kumekay/aronia/case/3mf/Aronia Case v35_Aronia Case v35_FFC Connector_1_FFC Connector.3mf

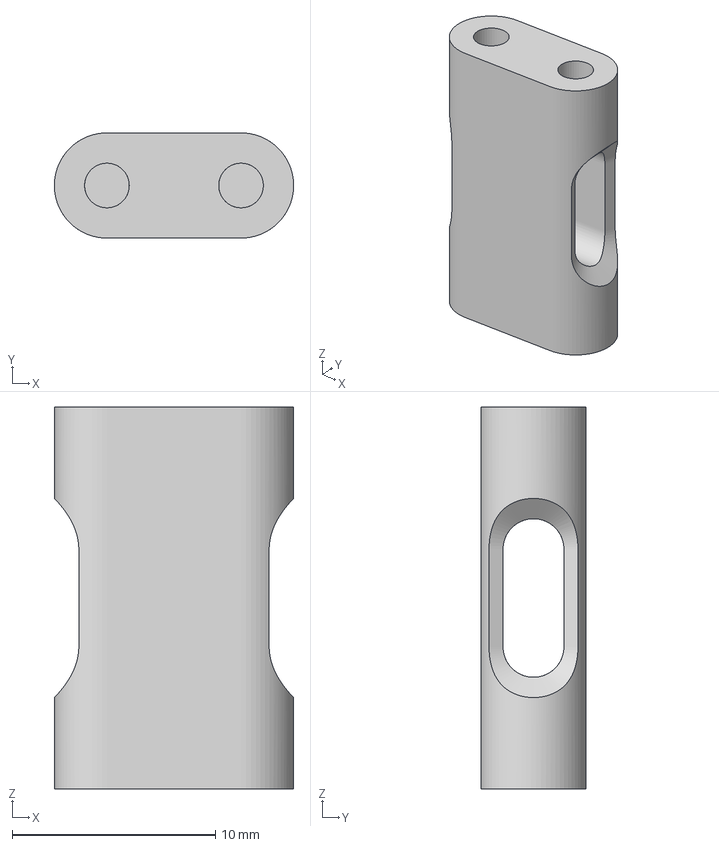
[picture p4: CAD file, 2025-06-29]
case/3mf/Aronia Case v35_Aronia Case v35_FFC Connector_1_FFC Connector.3mf
11.8 x 5.18 x 18.8 mm
