kumekay/aronia/flashing_helper/3mf/Pogo Flash v4_Pogo Flash v4_PCB Aligner.3mf

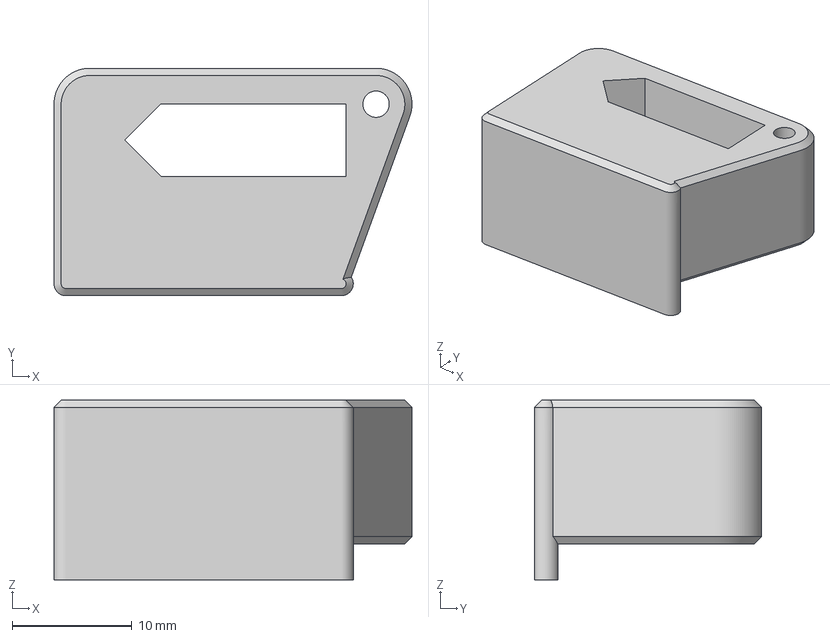
[picture p5: CAD file, 2025-06-29]
flashing_helper/3mf/Pogo Flash v4_Pogo Flash v4_PCB Aligner.3mf
29.9 x 19.0 x 15.0 mm
