kumekay/aronia/case/3mf/Aronia Case v35_Aronia Case v35_Spur Gear A_1_Gear A.3mf

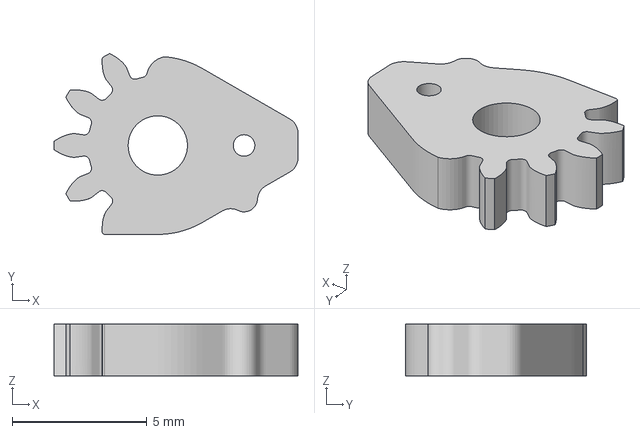
[picture p6: CAD file, 2025-06-29]
case/3mf/Aronia Case v35_Aronia Case v35_Spur Gear A_1_Gear A.3mf
9.05 x 6.71 x 1.92 mm
