kumekay/aronia/flashing_helper/3mf/Pogo Flash v4_Pogo Flash v4_Top cover_1_Cover.3mf

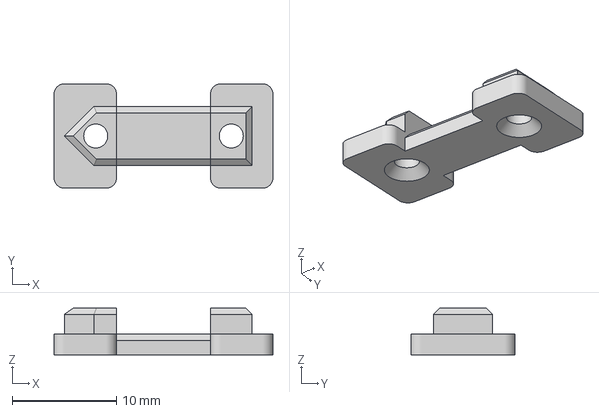
[picture p7: CAD file, 2025-06-29]
flashing_helper/3mf/Pogo Flash v4_Pogo Flash v4_Top cover_1_Cover.3mf
21.0 x 10.0 x 4.50 mm
