kumekay/aronia/case/3mf/Aronia Case v35_Aronia Case v35_Left Half_1_Left Half.3mf

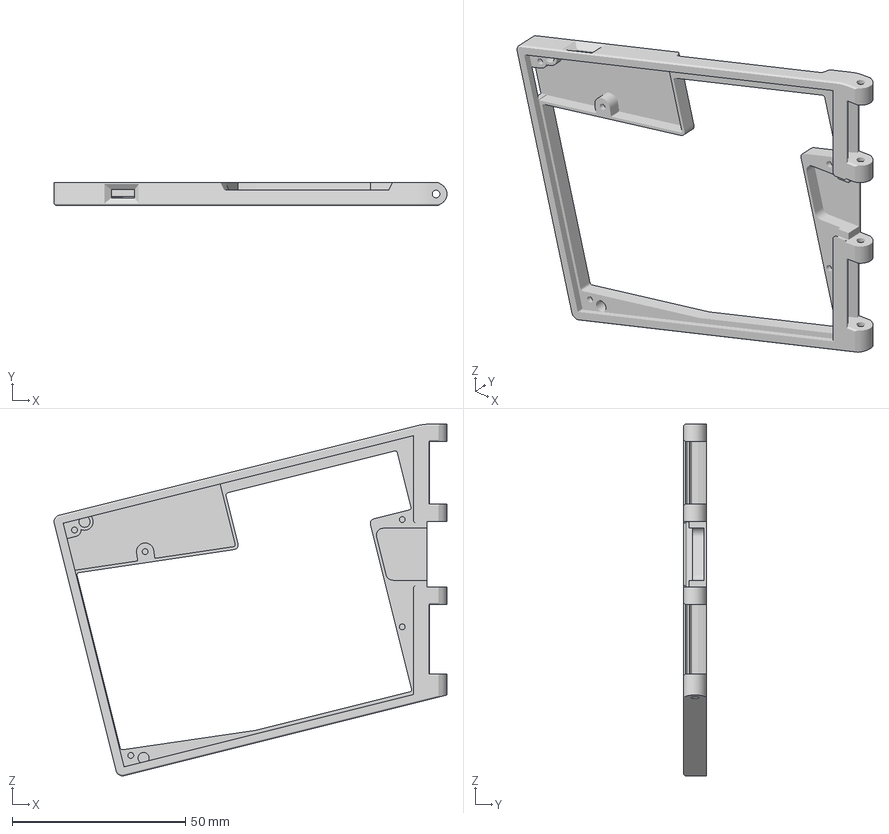
[picture p8: CAD file, 2025-06-29]
case/3mf/Aronia Case v35_Aronia Case v35_Left Half_1_Left Half.3mf
113.3 x 6.50 x 101.4 mm
