kumekay/aronia/flashing_helper/3mf/Pogo Flash v4_Pogo Flash v4_Bottom insert_1_Pin insert.3mf

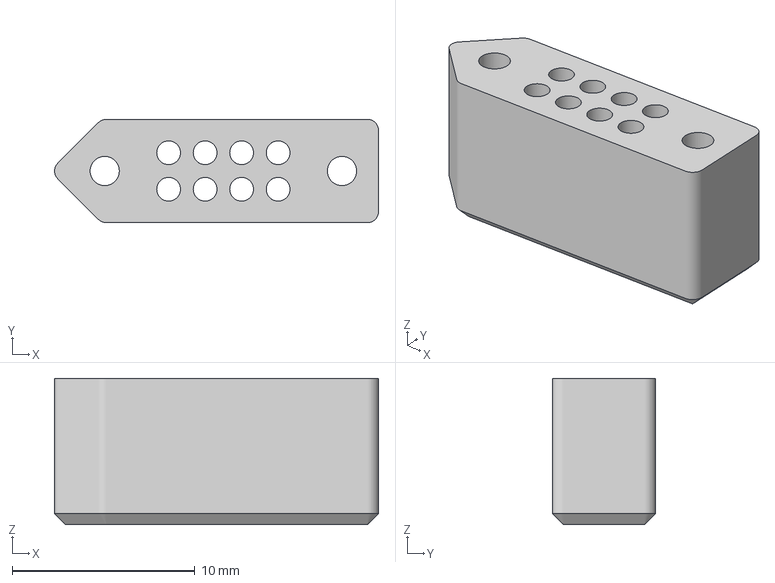
[picture p9: CAD file, 2025-06-29]
flashing_helper/3mf/Pogo Flash v4_Pogo Flash v4_Bottom insert_1_Pin insert.3mf
17.8 x 5.66 x 8.00 mm
