kumekay/aronia/case/3mf/Aronia Case v35_Aronia Case v35_Connector_1_Connector.3mf

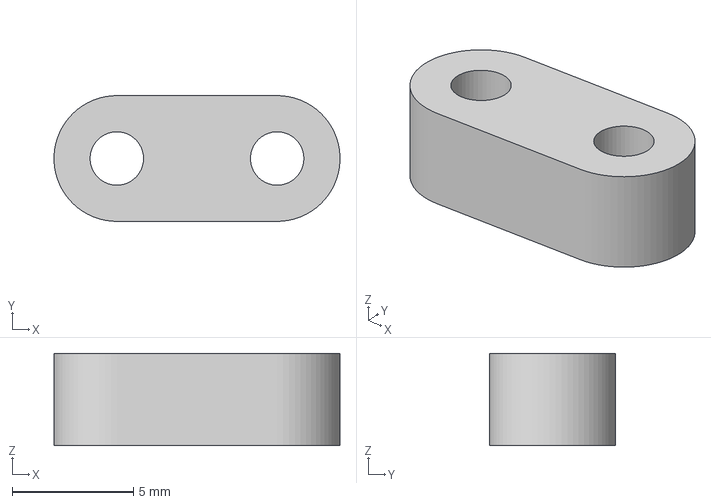
[picture p10: CAD file, 2025-06-29]
case/3mf/Aronia Case v35_Aronia Case v35_Connector_1_Connector.3mf
11.8 x 5.18 x 3.80 mm
