kumekay/aronia/case/3mf/Aronia Case v35_Aronia Case v35_Spur Gear B_1_Gear B.3mf

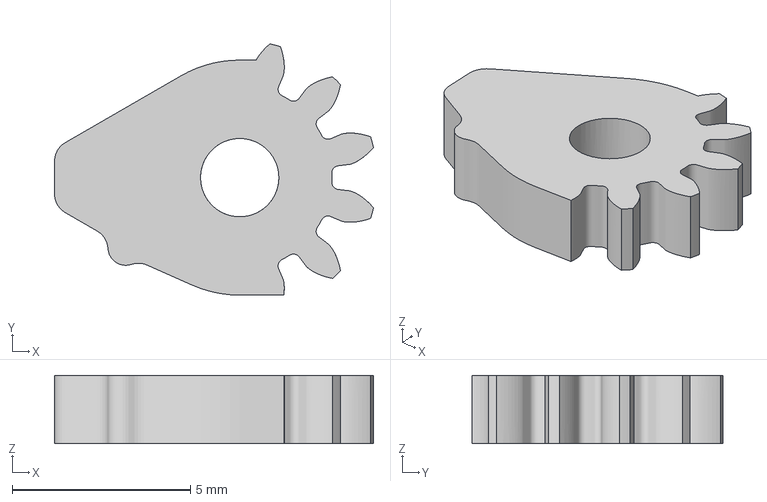
[picture p11: CAD file, 2025-06-29]
case/3mf/Aronia Case v35_Aronia Case v35_Spur Gear B_1_Gear B.3mf
8.96 x 7.06 x 1.92 mm
