kumekay/aronia/case/3mf/Aronia Case v35_Aronia Case v35_Right Cover_1_Right Cover.3mf

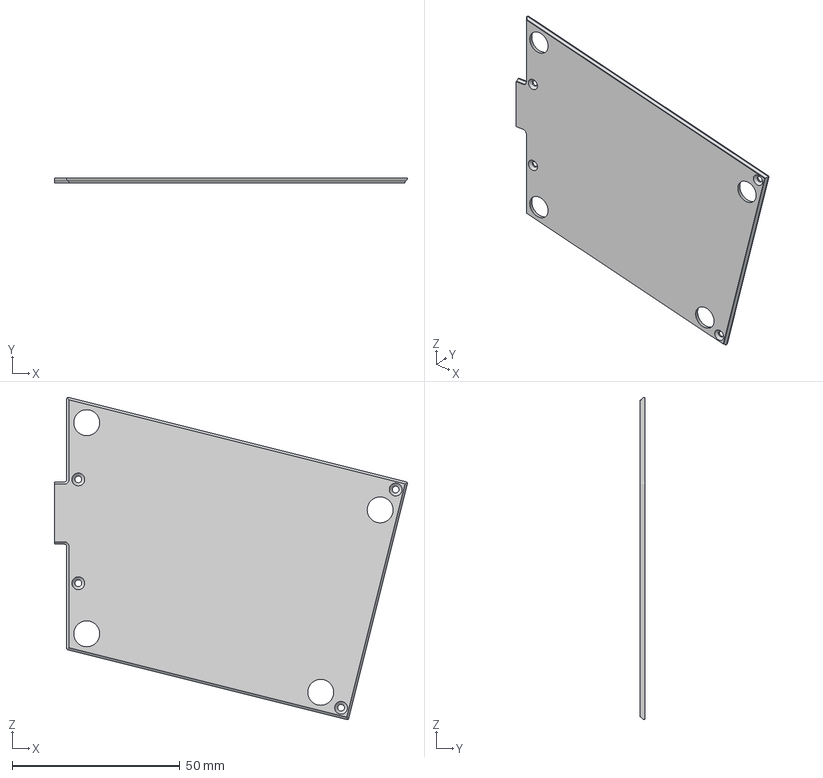
[picture p12: CAD file, 2025-06-29]
case/3mf/Aronia Case v35_Aronia Case v35_Right Cover_1_Right Cover.3mf
105.1 x 1.40 x 96.0 mm
