kumekay/aronia/case/3mf/Aronia Case v35_Aronia Case v35_Left Cover_1_Left Cover.3mf

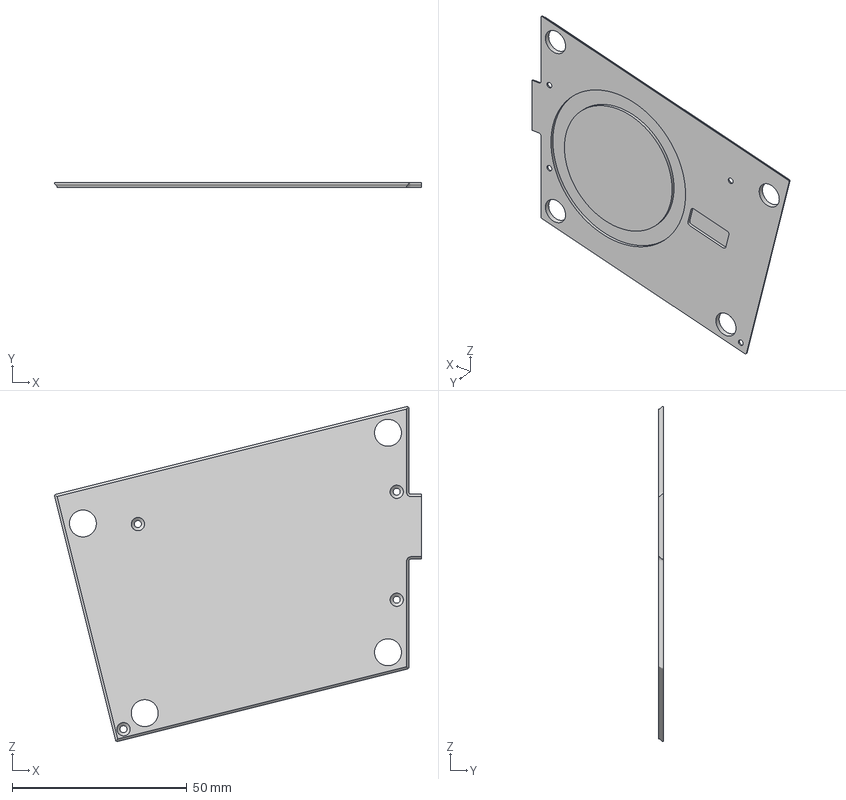
[picture p13: CAD file, 2025-06-29]
case/3mf/Aronia Case v35_Aronia Case v35_Left Cover_1_Left Cover.3mf
105.1 x 1.40 x 96.0 mm
