kumekay/aronia/(list of files, cad)

Other CAD files:
case/3mf/Aronia Case v35_Aronia Case v35_Right Half (1)_1_Left Half.3mf
case/Aronia Case v35.f3d
flashing_helper/Pogo Flash v4.f3d
