kumekay/aronia/pcb/aronia.kicad_sch

## KiCad design pcb/aronia.kicad_sch (2025-06-29)

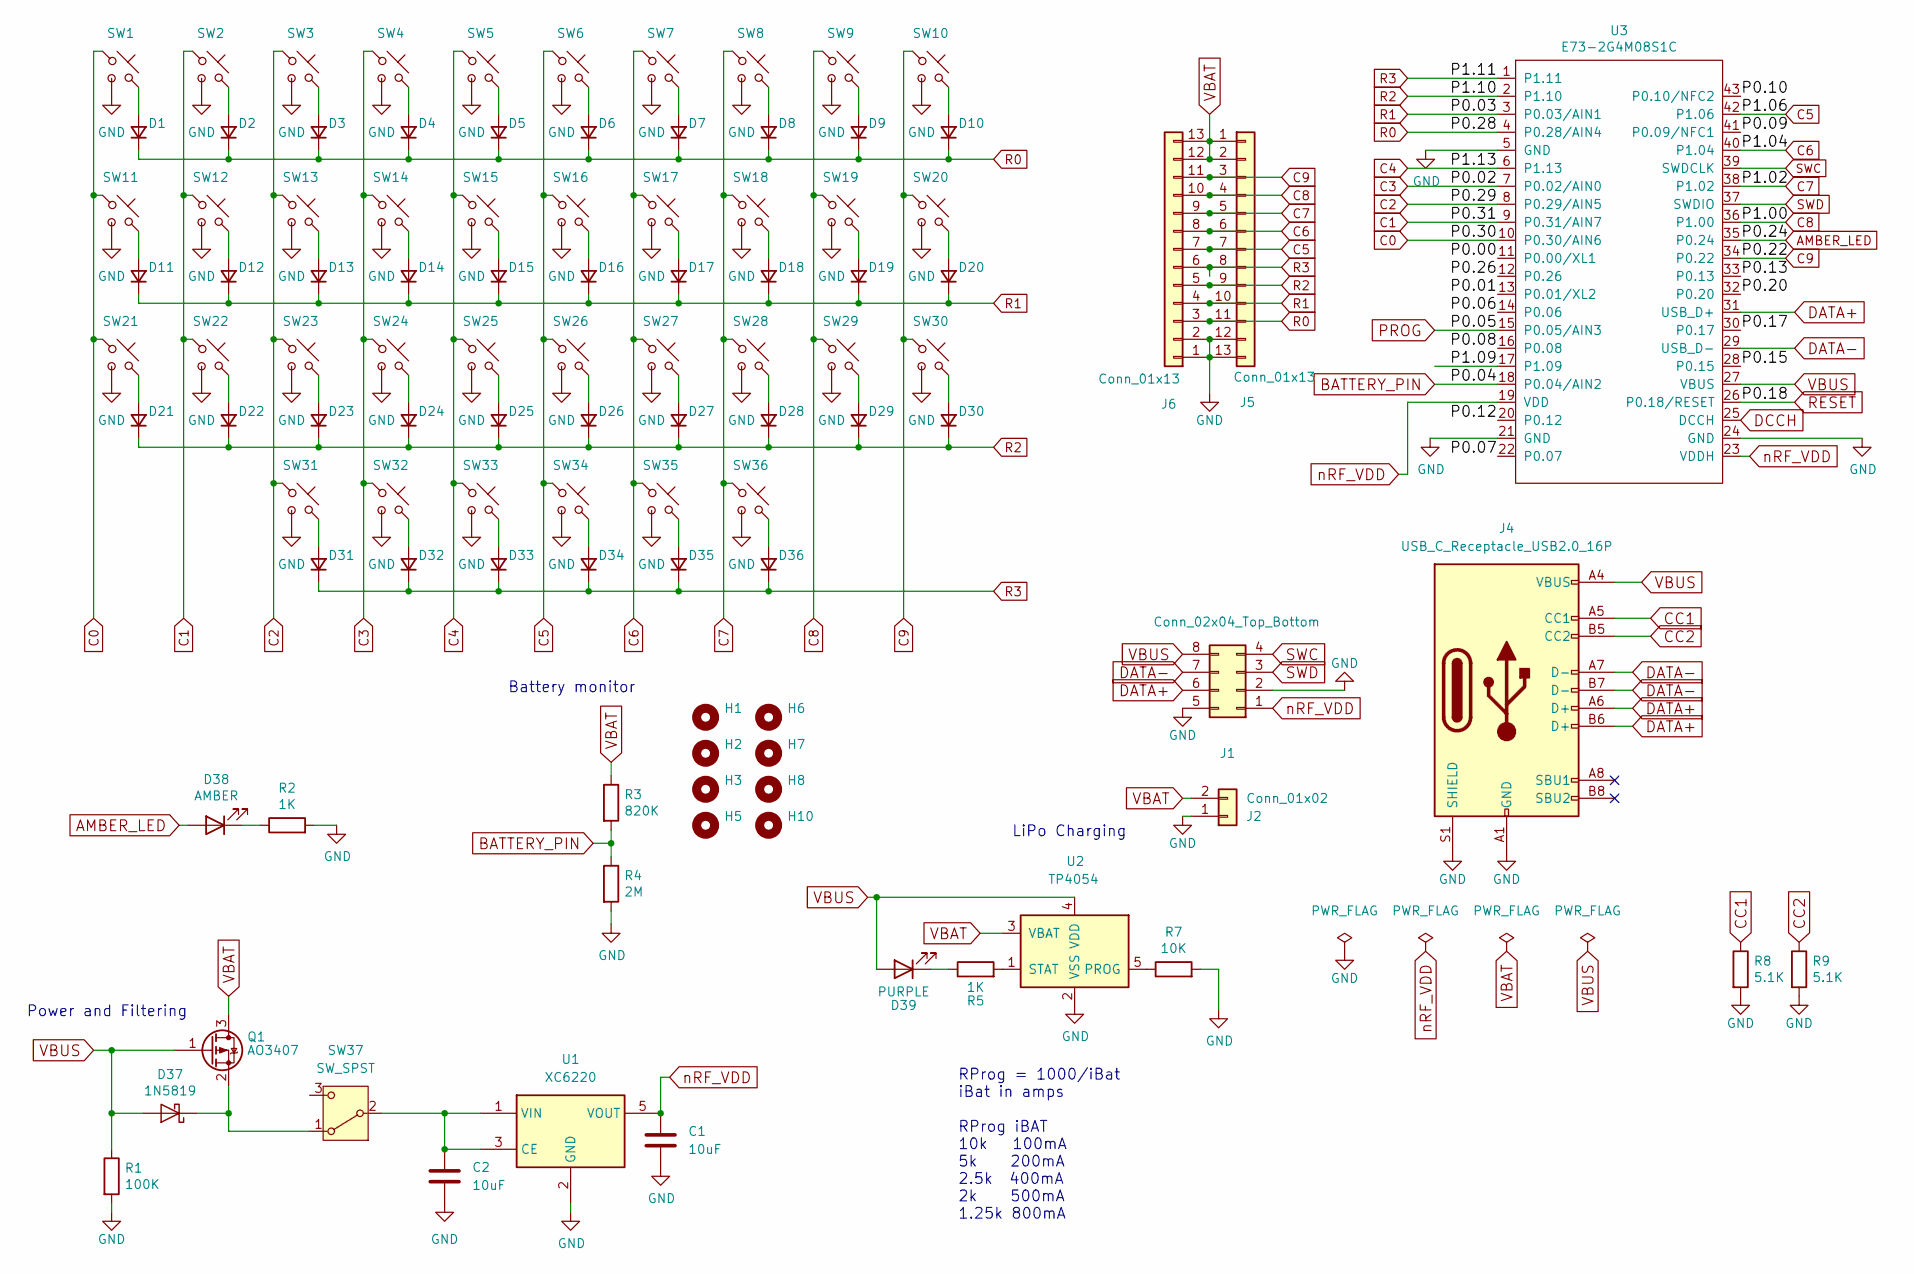
[picture p14: schematic aronia.kicad_sch]

Parts:
C1, C2: 10uF; C_0603_1608Metric; LCSC C7107636
D1, D2, D3, D4, D5, D6, D7, D8, D9, D10, D11, D12, D13, D14, D15, D16, D17, D18, D19, D20, D21, D22, D23, D24, D25, D26, D27, D28, D29, D30, D31, D32, D33, D34, D35, D36: D; D_SOD-323; LCSC C191023
D37: 1N5819; D_SOD-323; LCSC C191023
D38: AMBER; LED_0603_1608Metric; LCSC C7371907
D39: PURPLE; LED_0603_1608Metric; LCSC C7371898
H1, H2, H3, H5, H6, H7, H8, H10: MountingHole; MountingHole_2.2mm_M2
J1: Conn_02x04_Top_Bottom; PinHeader_2x04_P2.00mm_Vertical
J2: Conn_01x02; JST_PH_S2B-PH-K_1x02_P2.00mm_Horizontal
J4: USB_C_Receptacle_USB2.0_16P; USB_C_Receptacle_HCTL_HC-TYPE-C-16P-01A; LCSC C393939
J5, J6: Conn_01x13; hanxia-HX0.5-13P-CTXJ-H2.0-119; LCSC C5691137
Q1: AO3407; SOT-23; LCSC C347478
R1: 100K; R_0603_1608Metric; LCSC C25803
R2, R5: 1K; R_0603_1608Metric; LCSC C21190
R3: 820K; R_0603_1608Metric; LCSC C23252
R4: 2M; R_0603_1608Metric; LCSC C22976
R7: 10K; R_0603_1608Metric; LCSC C25804
R8, R9: 5.1K; R_0603_1608Metric; LCSC C23186
SW1, SW2, SW3, SW4, SW5, SW6, SW7, SW8, SW9, SW10, SW11, SW12, SW13, SW14, SW15, SW16, SW17, SW18, SW19, SW20, SW21, SW22, SW23, SW24, SW25, SW26, SW27, SW28, SW29, SW30, SW31, SW32, SW33, SW34, SW35, SW36: SW_Push; CPG1316S01D02
SW37: SW_SPST; SW_SSSS811101; LCSC C109335
U1: XC6220; SOT-23-5; LCSC C86534
U2: TP4054; SOT-23-5; LCSC C668215
U3: E73-2G4M08S1C; E73-2G4M08S1C-52840; LCSC C356849

Connections:
AMBER_LED: D38.2 (A), U3.35 (P0.24)
BATTERY_PIN: R3.2, R4.1, U3.18 (P0.04/AIN2)
C0: SW1.1, SW11.1, SW21.1, U3.10 (P0.30/AIN6)
C1: SW2.1, SW12.1, SW22.1, U3.9 (P0.31/AIN7)
C2: SW3.1, SW13.1, SW23.1, SW31.1, U3.8 (P0.29/AIN5)
C3: SW4.1, SW14.1, SW24.1, SW32.1, U3.7 (P0.02/AIN0)
C4: SW5.1, SW15.1, SW25.1, SW33.1, U3.6 (P1.13)
C5: J5.7, J6.7, SW6.1, SW16.1, SW26.1, SW34.1, U3.42 (P1.06)
C6: J5.6, J6.8, SW7.1, SW17.1, SW27.1, SW35.1, U3.40 (P1.04)
C7: J5.5, J6.9, SW8.1, SW18.1, SW28.1, SW36.1, U3.38 (P1.02)
C8: J5.4, J6.10, SW9.1, SW19.1, SW29.1, U3.36 (P1.00)
C9: J5.3, J6.11, SW10.1, SW20.1, SW30.1, U3.34 (P0.22)
CC1: J4.A5 (CC1), R8.1
CC2: J4.B5 (CC2), R9.1
DATA+: J1.6, J4.A6 (D+), J4.B6 (D+), U3.31 (USB_D+)
DATA-: J1.7, J4.A7 (D-), J4.B7 (D-), U3.29 (USB_D-)
DCCH: U3.25 (DCCH)
GND: C1.2, C2.2, J1.2, J1.5, J2.1, J4.A1 (GND), J4.A12 (GND), J4.B1 (GND), J4.B12 (GND), J4.S1 (SHIELD), J5.12, J5.13, J6.1, J6.2, R1.2, R2.2, R4.2, R7.2, R8.2, R9.2, SW1.3, SW2.3, SW3.3, SW4.3, SW5.3, SW6.3, SW7.3, SW8.3, SW9.3, SW10.3, SW11.3, SW12.3, SW13.3, SW14.3, SW15.3, SW16.3, SW17.3, SW18.3, SW19.3, SW20.3, SW21.3, SW22.3, SW23.3, SW24.3, SW25.3, SW26.3, SW27.3, SW28.3, SW29.3, SW30.3, SW31.3, SW32.3, SW33.3, SW34.3, SW35.3, SW36.3, U1.2 (GND), U2.2 (VSS), U3.5 (GND), U3.21 (GND), U3.24 (GND)
unnamed: C2.1, SW37.2 (B), U1.1 (VIN), U1.3 (CE)
unnamed: D1.2 (A), SW1.2
unnamed: D2.2 (A), SW2.2
unnamed: D3.2 (A), SW3.2
unnamed: D4.2 (A), SW4.2
unnamed: D5.2 (A), SW5.2
unnamed: D6.2 (A), SW6.2
unnamed: D7.2 (A), SW7.2
unnamed: D8.2 (A), SW8.2
unnamed: D9.2 (A), SW9.2
unnamed: D10.2 (A), SW10.2
unnamed: D11.2 (A), SW11.2
unnamed: D12.2 (A), SW12.2
unnamed: D13.2 (A), SW13.2
unnamed: D14.2 (A), SW14.2
unnamed: D15.2 (A), SW15.2
unnamed: D16.2 (A), SW16.2
unnamed: D17.2 (A), SW17.2
unnamed: D18.2 (A), SW18.2
unnamed: D19.2 (A), SW19.2
unnamed: D20.2 (A), SW20.2
unnamed: D21.2 (A), SW21.2
unnamed: D22.2 (A), SW22.2
unnamed: D23.2 (A), SW23.2
unnamed: D24.2 (A), SW24.2
unnamed: D25.2 (A), SW25.2
unnamed: D26.2 (A), SW26.2
unnamed: D27.2 (A), SW27.2
unnamed: D28.2 (A), SW28.2
unnamed: D29.2 (A), SW29.2
unnamed: D30.2 (A), SW30.2
unnamed: D31.2 (A), SW31.2
unnamed: D32.2 (A), SW32.2
unnamed: D33.2 (A), SW33.2
unnamed: D34.2 (A), SW34.2
unnamed: D35.2 (A), SW35.2
unnamed: D36.2 (A), SW36.2
unnamed: D37.1 (K), Q1.2 (S), SW37.1 (A)
unnamed: D38.1 (K), R2.1
unnamed: D39.1 (K), R5.1
unnamed: R5.2, U2.1 (STAT)
unnamed: R7.1, U2.5 (PROG)
P0.00: U3.11 (P0.00/XL1)
P0.01: U3.13 (P0.01/XL2)
P0.06: U3.14 (P0.06)
P0.07: U3.22 (P0.07)
P0.08: U3.16 (P0.08)
P0.09: U3.41 (P0.09/NFC1)
P0.10: U3.43 (P0.10/NFC2)
P0.12: U3.20 (P0.12)
P0.13: U3.33 (P0.13)
P0.15: U3.28 (P0.15)
P0.17: U3.30 (P0.17)
P0.20: U3.32 (P0.20)
P0.26: U3.12 (P0.26)
P1.09: U3.17 (P1.09)
PROG: U3.15 (P0.05/AIN3)
R0: D1.1 (K), D2.1 (K), D3.1 (K), D4.1 (K), D5.1 (K), D6.1 (K), D7.1 (K), D8.1 (K), D9.1 (K), D10.1 (K), J5.11, J6.3, U3.4 (P0.28/AIN4)
R1: D11.1 (K), D12.1 (K), D13.1 (K), D14.1 (K), D15.1 (K), D16.1 (K), D17.1 (K), D18.1 (K), D19.1 (K), D20.1 (K), J5.10, J6.4, U3.3 (P0.03/AIN1)
R2: D21.1 (K), D22.1 (K), D23.1 (K), D24.1 (K), D25.1 (K), D26.1 (K), D27.1 (K), D28.1 (K), D29.1 (K), D30.1 (K), J5.9, J6.5, U3.2 (P1.10)
R3: D31.1 (K), D32.1 (K), D33.1 (K), D34.1 (K), D35.1 (K), D36.1 (K), J5.8, J6.6, U3.1 (P1.11)
RESET: U3.26 (P0.18/RESET)
SWC: J1.4, U3.39 (SWDCLK)
SWD: J1.3, U3.37 (SWDIO)
VBAT: J2.2, J5.1, J5.2, J6.12, J6.13, Q1.3 (D), R3.1, U2.3 (VBAT)
VBUS: D37.2 (A), D39.2 (A), J1.8, J4.A4 (VBUS), J4.A9 (VBUS), J4.B4 (VBUS), J4.B9 (VBUS), Q1.1 (G), R1.1, U2.4 (VDD), U3.27 (VBUS)
nRF_VDD: C1.1, J1.1, U1.5 (VOUT), U3.19 (VDD), U3.23 (VDDH)

Notes on the sheet:
RProg = 1000/iBat iBat in amps RProg iBAT 10k 100mA 5k 200mA 2.5k 400mA 2k 500mA 1.25k 800mA
Battery monitor
Power and Filtering
LiPo Charging
